AlexRoss-xx/Subaru-media-lan/assets/dis.jpg

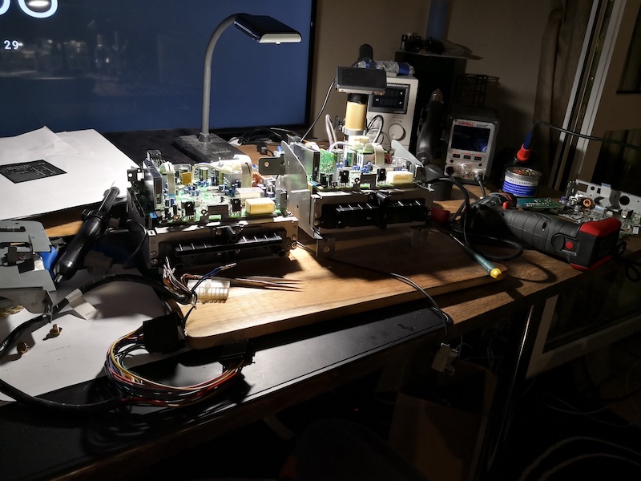
assets/dis.jpg
