AlexRoss-xx/Subaru-media-lan/assets/fuel.png

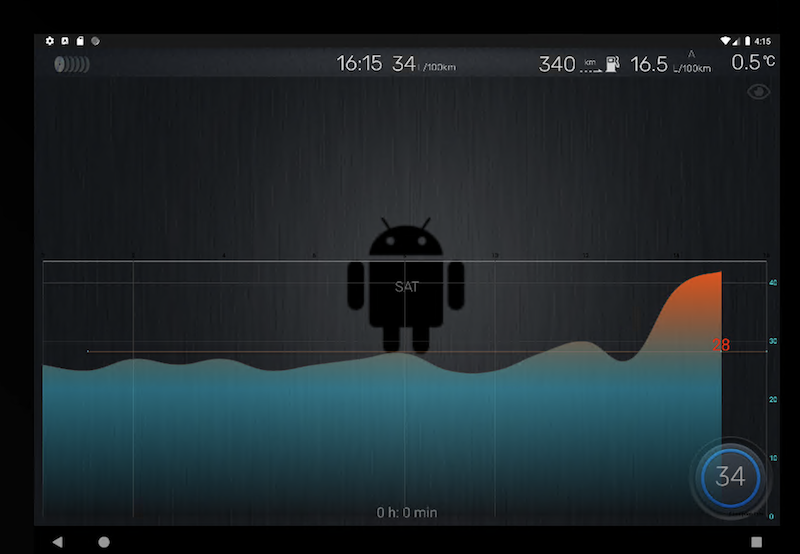
assets/fuel.png
