AlexRoss-xx/Subaru-media-lan/assets/scheme.png

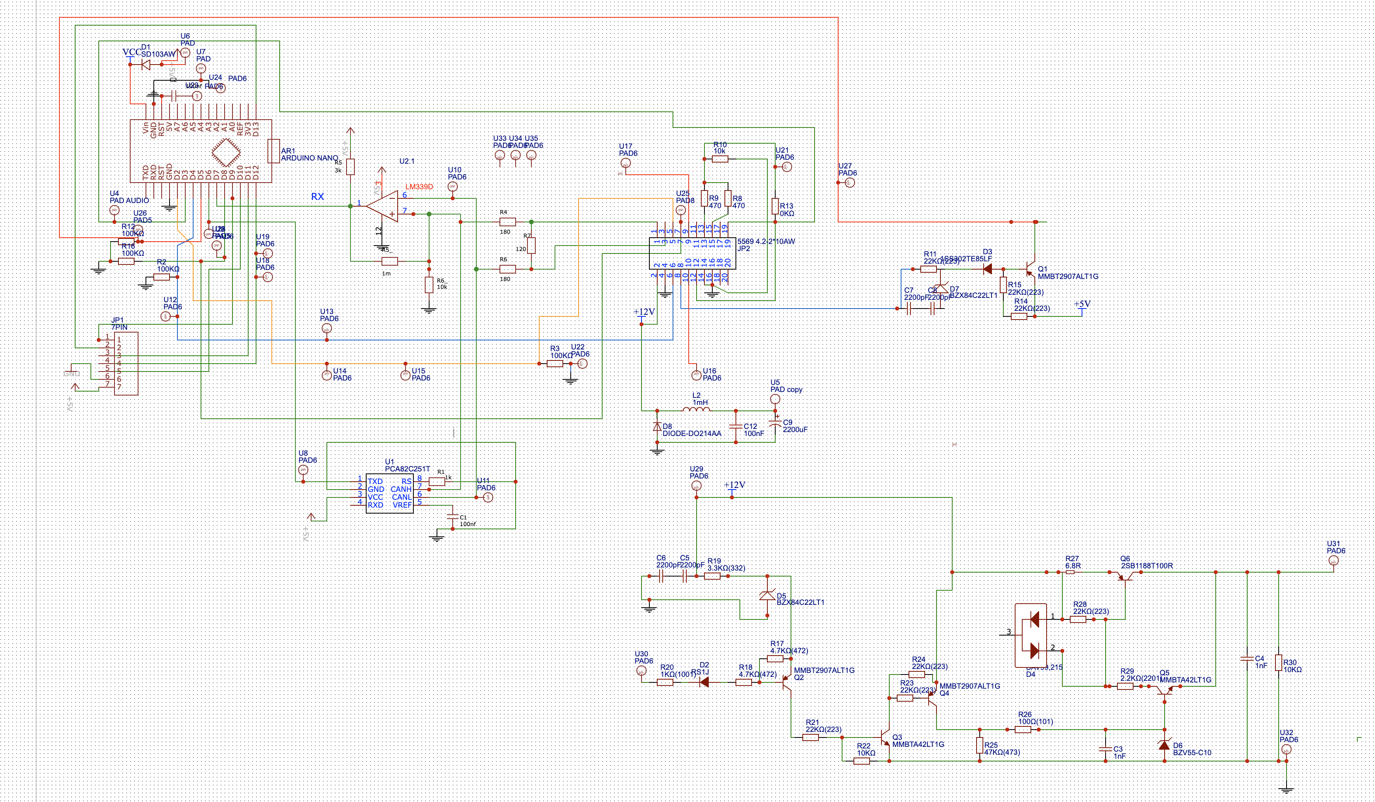
assets/scheme.png
